KULeuven-COSIC/asic_jitter_measure/hardware/conf_8/readme.md

# `conf_8` Module
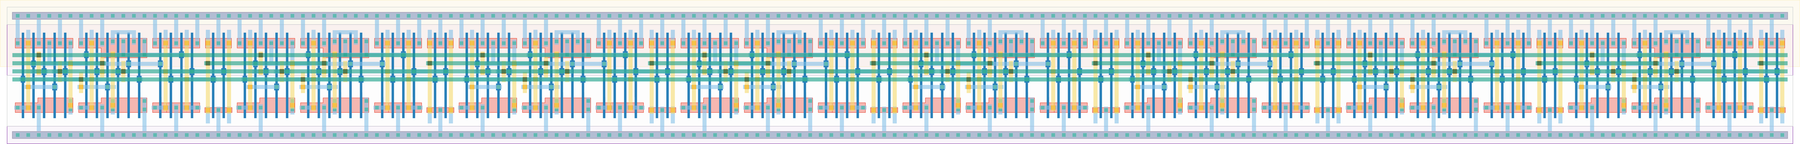
[picture p28: hardware/conf_8/conf_8.png]
Layout


## Cell Hierarchy

`conf_8` **136** (number MOS pairs)
- `conf_4` **68** *x2*

## Netlist

```
.SUBCKT conf_8 clk in out<0> out<1> out<2> out<3> out<4> out<5> out<6> out<7> rst rst' vdd vss
    Xi1 clk out<3> out<4> out<5> out<6> out<7> rst rst' vdd vss conf_4
    Xi0 clk in out<0> out<1> out<2> out<3> rst rst' vdd vss conf_4
.ENDS
```
