KULeuven-COSIC/asic_jitter_measure/hardware/dc_jit_128/readme.md

# `dc_jit_128` Module
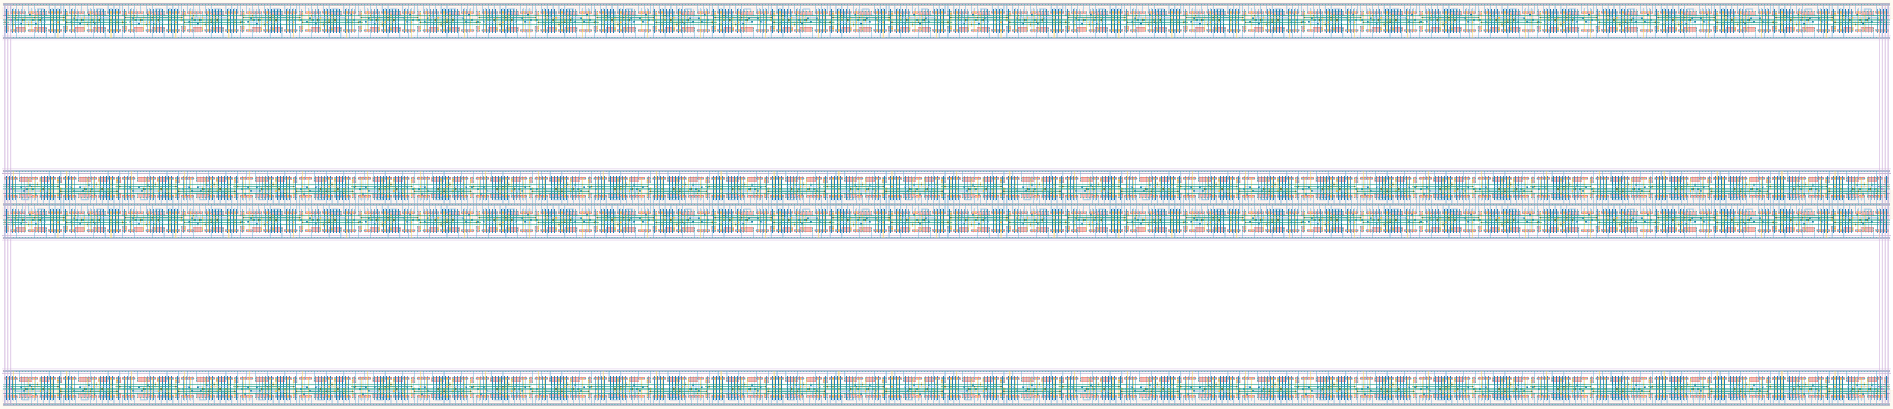
[picture p37: hardware/dc_jit_128/dc_jit_128.png]
Layout


## Cell Hierarchy

`dc_jit_128` **2048** (number MOS pairs)
- `dc_jit_64` **1024** *x2*

## Netlist

```
.SUBCKT dc_jit_128 clk in last out<0> out<1> out<2> out<3> out<4> out<5> out<6> out<7> out<8> out<9>
                   + out<10> out<11> out<12> out<13> out<14> out<15> out<16> out<17> out<18> out<19>
                   + out<20> out<21> out<22> out<23> out<24> out<25> out<26> out<27> out<28> out<29>
                   + out<30> out<31> out<32> out<33> out<34> out<35> out<36> out<37> out<38> out<39>
                   + out<40> out<41> out<42> out<43> out<44> out<45> out<46> out<47> out<48> out<49>
                   + out<50> out<51> out<52> out<53> out<54> out<55> out<56> out<57> out<58> out<59>
                   + out<60> out<61> out<62> out<63> out<64> out<65> out<66> out<67> out<68> out<69>
                   + out<70> out<71> out<72> out<73> out<74> out<75> out<76> out<77> out<78> out<79>
                   + out<80> out<81> out<82> out<83> out<84> out<85> out<86> out<87> out<88> out<89>
                   + out<90> out<91> out<92> out<93> out<94> out<95> out<96> out<97> out<98> out<99>
                   + out<100> out<101> out<102> out<103> out<104> out<105> out<106> out<107>
                   + out<108> out<109> out<110> out<111> out<112> out<113> out<114> out<115>
                   + out<116> out<117> out<118> out<119> out<120> out<121> out<122> out<123>
                   + out<124> out<125> out<126> out<127> rst rst' vdd vss
    Xi1 clk int last out<64> out<65> out<66> out<67> out<68> out<69> out<70> out<71> out<72> out<73>
        + out<74> out<75> out<76> out<77> out<78> out<79> out<80> out<81> out<82> out<83> out<84>
        + out<85> out<86> out<87> out<88> out<89> out<90> out<91> out<92> out<93> out<94> out<95>
        + out<96> out<97> out<98> out<99> out<100> out<101> out<102> out<103> out<104> out<105>
        + out<106> out<107> out<108> out<109> out<110> out<111> out<112> out<113> out<114> out<115>
        + out<116> out<117> out<118> out<119> out<120> out<121> out<122> out<123> out<124> out<125>
        + out<126> out<127> rst rst' vdd vss dc_jit_64
    Xi0 clk in int out<0> out<1> out<2> out<3> out<4> out<5> out<6> out<7> out<8> out<9> out<10>
        + out<11> out<12> out<13> out<14> out<15> out<16> out<17> out<18> out<19> out<20> out<21>
        + out<22> out<23> out<24> out<25> out<26> out<27> out<28> out<29> out<30> out<31> out<32>
        + out<33> out<34> out<35> out<36> out<37> out<38> out<39> out<40> out<41> out<42> out<43>
        + out<44> out<45> out<46> out<47> out<48> out<49> out<50> out<51> out<52> out<53> out<54>
        + out<55> out<56> out<57> out<58> out<59> out<60> out<61> out<62> out<63> rst rst' vdd vss
        + dc_jit_64
.ENDS
```
