KULeuven-COSIC/asic_jitter_measure/hardware/dc_jit_32/readme.md

# `dc_jit_32` Module
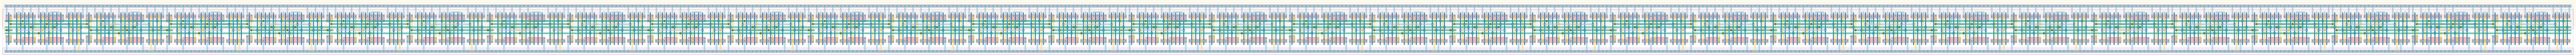
[picture p40: hardware/dc_jit_32/dc_jit_32.png]
Layout


## Cell Hierarchy

`dc_jit_32` **512** (number MOS pairs)
- `dc_jit_16` **256** *x2*

## Netlist

```
.SUBCKT dc_jit_32 clk in last out<0> out<1> out<2> out<3> out<4> out<5> out<6> out<7> out<8> out<9>
                  + out<10> out<11> out<12> out<13> out<14> out<15> out<16> out<17> out<18> out<19>
                  + out<20> out<21> out<22> out<23> out<24> out<25> out<26> out<27> out<28> out<29>
                  + out<30> out<31> rst rst' vdd vss
    Xi1 clk int last out<16> out<17> out<18> out<19> out<20> out<21> out<22> out<23> out<24> out<25>
        + out<26> out<27> out<28> out<29> out<30> out<31> rst rst' vdd vss dc_jit_16
    Xi0 clk in int out<0> out<1> out<2> out<3> out<4> out<5> out<6> out<7> out<8> out<9> out<10>
        + out<11> out<12> out<13> out<14> out<15> rst rst' vdd vss dc_jit_16
.ENDS
```
