KULeuven-COSIC/asic_jitter_measure/hardware/freq_scaler3/readme.md

# `freq_scaler3` Module
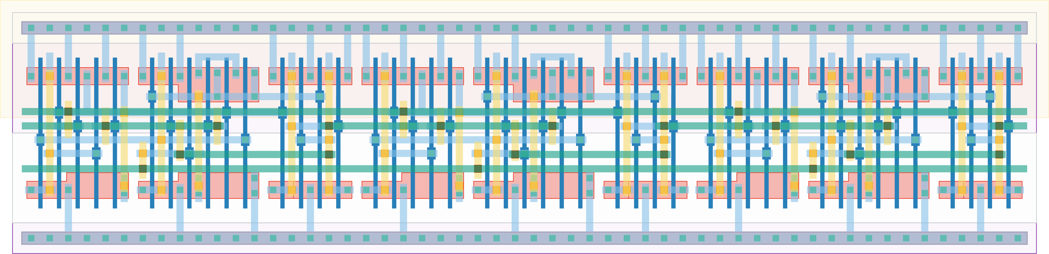
[picture p59: hardware/freq_scaler3/freq_scaler3.png]
Layout
