KULeuven-COSIC/asic_jitter_measure/hardware/mero_3e_2b/readme.md

# `mero_3e_2b` Module
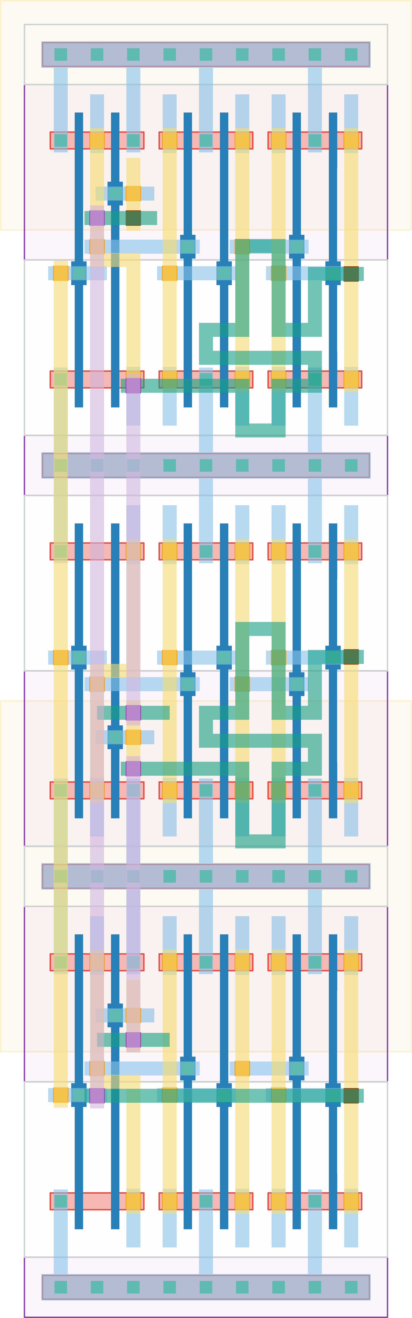
[picture p65: hardware/mero_3e_2b/mero_3e_2b.png]
Layout


## Cell Hierarchy

`mero_3e_2b` **18** (number MOS pairs)
- `mero_nand2` **2** *x3*
- `mero_buf` **2** *x6*

## Netlist

```
.SUBCKT mero_3e_2b enable out0 out1 out2 vdd vss
    Xi2 out1 enable int2<0> vdd vss mero_nand2
    Xi1 out0 enable int1<0> vdd vss mero_nand2
    Xi0 out2 enable int0<0> vdd vss mero_nand2
    Xi8 int2<1> out2 vdd vss mero_buf
    Xi7 int2<0> int2<1> vdd vss mero_buf
    Xi6 int1<1> out1 vdd vss mero_buf
    Xi5 int1<0> int1<1> vdd vss mero_buf
    Xi4 int0<1> out0 vdd vss mero_buf
    Xi3 int0<0> int0<1> vdd vss mero_buf
.ENDS
```
