KULeuven-COSIC/asic_jitter_measure/hardware/tff_st_ar/readme.md

# `tff_st_ar` Module
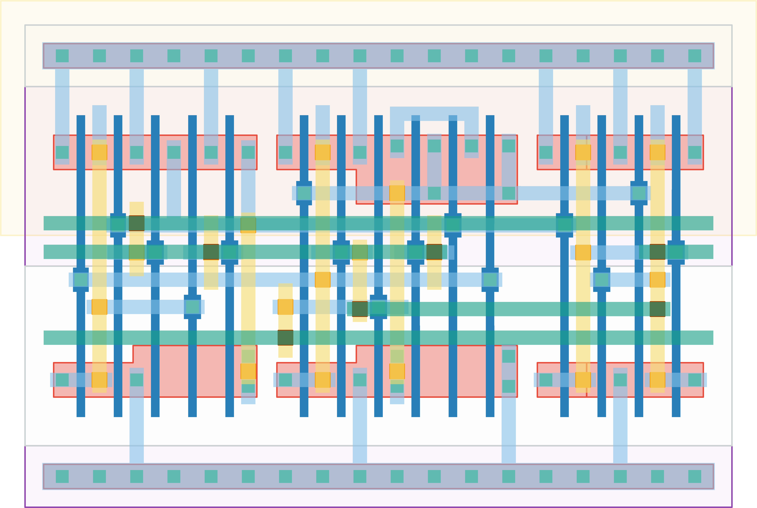
[picture p115: hardware/tff_st_ar/tff_st_ar.png]
Layout


## Cell Hierarchy

`tff_st_ar` **15** (number MOS pairs)
- `dff_st_ar` **15**

## Netlist

```
.SUBCKT tff_st_ar clk q q' rst rst' vdd vss
    Xi0 clk q' q q' rst rst' vdd vss dff_st_ar
.ENDS
```
