KULeuven-COSIC/asic_jitter_measure/hardware/vdd_gate_1ma/readme.md

# `vdd_gate_1ma` Module
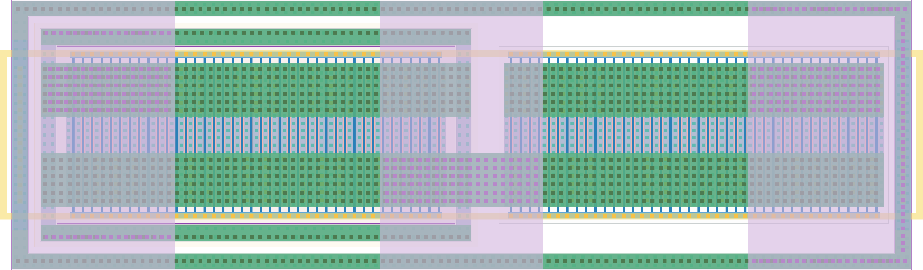
[picture p116: hardware/vdd_gate_1ma/vdd_gate_1ma.png]
Layout


## Cell Hierarchy

`vdd_gate_1ma` **0** (number MOS pairs)
- `p_mos_lvt` **0**
- `n_mos_lvt` **0**

## Netlist

```
.SUBCKT vdd_gate_1ma enable' vdd_in vdd_out vss
    Mm0 vdd_out enable' vdd_in vdd_in p_mos_lvt l=60n w=4u m=40
    Mm1 vdd_out enable' vss vss n_mos_lvt l=60n w=4u m=40
.ENDS
```
