KULeuven-COSIC/asic_jitter_measure/measurements/readout/readme.md

# Measurement scripts

This folder contains the following measurement scripts:
- **m1_charac_dc.py**: Characterize DCs using a Monte Carlo method.
- **m3_noise_measure.py**: Sweep accumulation time, measure phases multiple times to estimate noise contributions.
