KULeuven-COSIC/asic_jitter_measure/measurements/m1/m1_chip2_temp15_sup1.2_acc1_num1000_conf0-1-0-1.csv

Stage | dP0 [s] | dN0 [s] | dP1 [s] | dN1 [s]
0 | 0.0 | 0.0 | 0.0 | 0.0
1 | 1.3993482775218422e-11 | 3.6732892284948355e-11 | 4.6393713533901004e-11 | 0.0
2 | 8.745926734511513e-12 | 2.7986965550436845e-11 | 2.8167611788439895e-11 | 2.651069344794343e-11
3 | 5.422474575397139e-11 | 3.498370693804605e-11 | 2.1539938426454038e-11 | 4.473679519340454e-11
4 | 1.9241038815925332e-11 | 4.897718971326447e-11 | 1.1598428383475251e-11 | 2.8167611788439895e-11
5 | 4.023126297875296e-11 | 1.2244297428316118e-11 | 4.8050631874397465e-11 | 2.9824530128936356e-11
6 | 1.2244297428316118e-11 | 6.99674138760921e-11 | 1.1598428383475251e-11 | 4.8050631874397465e-11
7 | 7.521496991679901e-11 | 0.0 | 3.1481448469432823e-11 | 2.3196856766950502e-11
8 | 1.9241038815925332e-11 | 2.0990224162827634e-11 | 5.467830523638333e-11 | 3.3138366809929284e-11
9 | 2.2739409509729934e-11 | 7.871334061060363e-11 | 5.302138689588686e-11 | 5.633522357687979e-11
10 | 0.0 | 3.1485336244241447e-11 | 8.284591702482321e-12 | 2.651069344794343e-11
11 | 6.12214871415806e-11 | 4.3729633672557565e-11 | 1.6569183404964642e-11 | 0.0
12 | 0.0 | 4.198044832565527e-11 | 2.8167611788439895e-11 | 6.130597859836918e-11
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
