KULeuven-COSIC/asic_jitter_measure/measurements/m1/m1_chip2_temp15_sup1.2_acc1_num1000_conf0-13-0-5.csv

Stage | dP0 [s] | dN0 [s] | dP1 [s] | dN1 [s]
0 | 0.0 | 0.0 | 0.0 | 0.0
1 | 1.8722076417355378e-11 | 4.524501800860882e-11 | 2.7688908072752047e-11 | 0.0
2 | 7.800865173898074e-12 | 5.1485710147727284e-11 | 3.845681676771118e-11 | 2.6150635402043598e-11
3 | 4.524501800860882e-11 | 2.1842422486914605e-11 | 1.3844454036376023e-11 | 7.383708819400547e-11
4 | 2.340259552169422e-11 | 4.056449890426998e-11 | 9.229636024250683e-12 | 2.7688908072752047e-11
5 | 6.240692139118459e-11 | 1.2481384278236918e-11 | 8.306672421825614e-11 | 2.7688908072752047e-11
6 | 7.800865173898074e-12 | 6.396709442596421e-11 | 7.691363353542236e-12 | 3.230372608487739e-11
7 | 5.928657532162535e-11 | 0.0 | 4.460990745054497e-11 | 3.230372608487739e-11
8 | 2.4962768556473836e-11 | 2.4962768556473836e-11 | 5.999263415762944e-11 | 2.3074090060626707e-11
9 | 2.652294159125345e-11 | 6.864761353030305e-11 | 4.460990745054497e-11 | 5.6916088816212546e-11
10 | 0.0 | 3.2763633730371906e-11 | 1.3844454036376023e-11 | 2.7688908072752047e-11
11 | 8.112899780853996e-11 | 3.588397979993114e-11 | 1.2306181365667578e-11 | 0.0
12 | 0.0 | 4.524501800860882e-11 | 4.6148180121253414e-11 | 5.6916088816212546e-11
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
