KULeuven-COSIC/asic_jitter_measure/measurements/m1/m1_chip2_temp15_sup1.2_acc1_num1000_conf0-51-0-51.csv

Stage | dP0 [s] | dN0 [s] | dP1 [s] | dN1 [s]
0 | 0.0 | 0.0 | 0.0 | 0.0
1 | 2.1697708168965497e-11 | 4.7011701032758576e-11 | 3.6763887276359045e-11 | 0.0
2 | 1.4465138779310329e-11 | 5.062798572758615e-11 | 4.122011603712984e-11 | 2.4509258184239362e-11
3 | 3.9779131643103406e-11 | 3.736827517988502e-11 | 2.562331537443206e-11 | 6.90715457919473e-11
4 | 1.928685170574711e-11 | 3.6162846948275824e-11 | 5.570285950963492e-12 | 2.005302942346857e-11
5 | 3.857370341149422e-11 | 9.643425852873555e-12 | 5.236068793905682e-11 | 3.230765851558825e-11
6 | 1.4465138779310329e-11 | 6.870940920172406e-11 | 3.342171570578095e-12 | 3.899200165674444e-11
7 | 8.0763691517816e-11 | 0.0 | 3.6763887276359045e-11 | 2.4509258184239362e-11
8 | 3.254656225344824e-11 | 2.2903136400574688e-11 | 5.904503108021301e-11 | 3.0079544135202855e-11
9 | 2.8930277558620657e-11 | 6.388769627528728e-11 | 5.4588802319442214e-11 | 4.2334173227322534e-11
10 | 1.2054282316091943e-12 | 2.8930277558620657e-11 | 1.2254629092119681e-11 | 3.5649830086166344e-11
11 | 6.629855273850569e-11 | 2.7724849327011467e-11 | 1.2254629092119681e-11 | 0.0
12 | 0.0 | 3.9779131643103406e-11 | 3.6763887276359045e-11 | 5.6816916699827615e-11
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
