KULeuven-COSIC/asic_jitter_measure/measurements/m1/m1_chip2_temp15_sup1.2_acc1_num1000_conf15-0-15-0.csv

Stage | dP0 [s] | dN0 [s] | dP1 [s] | dN1 [s]
0 | 0.0 | 0.0 | 0.0 | 0.0
1 | 1.521087543764384e-11 | 4.157639286289316e-11 | 3.7535498121731394e-11 | 0.0
2 | 9.126525262586305e-12 | 4.9688859762969876e-11 | 4.691937265216424e-11 | 3.232223449371315e-11
3 | 4.157639286289316e-11 | 3.042175087528768e-11 | 2.8151623591298546e-11 | 6.568712171302994e-11
4 | 1.9267108887682198e-11 | 3.549204268783562e-11 | 1.4597138158451098e-11 | 2.8151623591298546e-11
5 | 5.171697648798905e-11 | 1.4196817075134251e-11 | 5.0047330828975195e-11 | 3.023692904250585e-11
6 | 1.2168700350115073e-11 | 7.098408537567124e-11 | 1.0426527256036499e-11 | 5.0047330828975195e-11
7 | 7.605437718821921e-11 | 0.0 | 3.023692904250585e-11 | 2.9194276316902196e-11
8 | 2.5351459062739734e-11 | 2.3323342337720554e-11 | 7.924160714587739e-11 | 3.7535498121731394e-11
9 | 2.3323342337720554e-11 | 6.591379356312331e-11 | 4.7962025377767894e-11 | 6.46444689874263e-11
10 | 0.0 | 4.2590451225402756e-11 | 1.7725096335262047e-11 | 3.023692904250585e-11
11 | 9.126525262586303e-11 | 3.042175087528768e-11 | 9.383874530432849e-12 | 0.0
12 | 0.0 | 4.157639286289316e-11 | 3.440753994492045e-11 | 4.58767199265606e-11
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
