KULeuven-COSIC/asic_jitter_measure/measurements/m1/m1_chip2_temp25_sup1.2_acc0.07_num1000_conf1-235-1-242.csv

Stage | dP0 [s] | dN0 [s] | dP1 [s] | dN1 [s]
0 | 0.0 | 0.0 | 0.0 | 0.0
1 | 1.809330367534374e-11 | 4.6238442725878445e-11 | 3.0278139165669817e-11 | 0.0
2 | 1.4072569525267353e-11 | 3.01555061255729e-11 | 4.238939483193774e-11 | 2.018542611044654e-11
3 | 4.422807565084025e-11 | 3.819697442572567e-11 | 2.422251133253585e-11 | 4.037085222089308e-11
4 | 2.2114037825420126e-11 | 4.824880980091664e-11 | 1.2111255666267925e-11 | 1.4129798277312579e-11
5 | 4.422807565084025e-11 | 8.041468300152773e-12 | 5.0463565276116355e-11 | 3.6333766998803776e-11
6 | 1.4072569525267353e-11 | 6.634211347626038e-11 | 1.009271305522327e-11 | 4.4407937442982395e-11
7 | 6.433174640122218e-11 | 0.0 | 3.431522438775912e-11 | 2.2203968721491198e-11
8 | 1.6082936600305546e-11 | 2.8145139050534706e-11 | 5.6519193109250314e-11 | 2.6241053943580504e-11
9 | 1.809330367534374e-11 | 5.629027810106941e-11 | 4.4407937442982395e-11 | 4.642648005402705e-11
10 | 0.0 | 4.221770857580206e-11 | 1.8166883499401888e-11 | 1.6148340888357235e-11
11 | 9.247688545175689e-11 | 3.618660735068748e-11 | 8.074170444178617e-12 | 2.0185426110446544e-12
12 | 0.0 | 5.2269543950993025e-11 | 4.642648005402705e-11 | 6.055627833133963e-11
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
