KULeuven-COSIC/asic_jitter_measure/measurements/m1/m1_chip2_temp25_sup1.2_acc0.07_num2000_conf1-235-1-242.csv

Stage | dP0 [s] | dN0 [s] | dP1 [s] | dN1 [s]
0 | 0.0 | 0.0 | 0.0 | 0.0
1 | 7.036970478793512e-12 | 4.021125987882006e-11 | 3.2248998522935656e-11 | 0.0
2 | 1.2063377963646018e-11 | 4.021125987882006e-11 | 4.031124815366956e-11 | 2.6202311299885216e-11
3 | 3.920597838184956e-11 | 2.9153163412144544e-11 | 1.108559324225913e-11 | 7.054468426892174e-11
4 | 1.4073940957587023e-11 | 3.116372640608555e-11 | 9.070030834575653e-12 | 1.7132280465309568e-11
5 | 4.6242948860643076e-11 | 1.4073940957587023e-11 | 5.4420185007453913e-11 | 2.9225654911410434e-11
6 | 1.809506694546903e-11 | 5.4285200836407084e-11 | 1.108559324225913e-11 | 4.031124815366956e-11
7 | 8.444364574552213e-11 | 0.0 | 3.1241217319093915e-11 | 2.8217873707568694e-11
8 | 2.7142600418203542e-11 | 3.619013389093806e-11 | 5.4420185007453913e-11 | 2.7210092503726957e-11
9 | 2.513203742426254e-11 | 7.539611227278762e-11 | 3.0233436115252175e-11 | 5.038906019208696e-11
10 | 1.0052814969705015e-12 | 3.820069688487906e-11 | 1.209337444610087e-11 | 2.6202311299885216e-11
11 | 9.952286820007965e-11 | 3.317428940002655e-11 | 6.046687223050435e-12 | 0.0
12 | 0.0 | 4.423238586670207e-11 | 3.930346694982783e-11 | 5.139684139592869e-11
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
