KULeuven-COSIC/asic_jitter_measure/(commit log)

2024-12-13 Added figures and measurement data
    [m1_chip2_temp15_sup1.2_acc1_num1000_conf0-1-0-1.csv, m1_chip2_temp15_sup1.2_acc1_num1000_conf0-13-0-5.csv, m1_chip2_temp15_sup1.2_acc1_num1000_conf0-51-0-51.csv, m1_chip2_temp15_sup1.2_acc1_num1000_conf15-0-15-0.csv, m1_chip2_temp25_sup1.2_acc0.07_num1000_conf1-235-1-242.csv, m1_chip2_temp25_sup1.2_acc0.07_num2000_conf1-235-1-242.csv, m1_chip2_temp25_sup1.2_acc0.07_num4000_conf1-235-1-242.csv, m1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]
2024-12-13 Added readmes to measurements
    [m1_chip2_temp25_sup1.2_acc0.1_num1000_conf1-235-1-242_old.csv]
